finlaywashere/OpenDMXController/PCB/BOM.csv

ID | Name | Designator | Footprint | Quantity | Manufacturer Part | Manufacturer | Supplier | Supplier Part | Price
1 | AVR_SPI_PROG | U7 | AVR_ICSP | 1 | 220S-2*5P H=8.5MM Ytype Gold-plated | Ckmtw | LCSC | C124423 | 0.127
2 | ATMEGA2560 | U1 | TQFP100 | 1 | ATMEGA2560-16AU | MICROCHIP | LCSC | C22460 | 10.33
3 | M08 | JP1 | 1X08_LONGPADS | 1 | Female headerHDR1X8-2.54 | BOOMELE | LCSC | C27438 | 0.075
4 | 120 | R5,R6 | R1206 | 2 | 1206W4J0121T5E | UniOhm | LCSC | C25351 | 0.003
5 | 1M | R1 | R0603 | 1 | RMC06031M1%N | Tyohm | LCSC | C269705 | 0.003
6 | 1uF | C1 | C0805 | 1 | CS2012X7R105K500NRE | Samwha Capacitor | LCSC | C516002 | 0.015
7 | 10K | R2 | R1206 | 1 | PTFR1206B10K0P9 | ResistorToday | LCSC | C351536 | 0.172
8 | SI8660AB-B-IS1 | U2 | SOIC-16_L9.9-W3.9-P1.27-LS6.0-BL | 1 | SI8660AB-B-IS1 | SILICON LABS | LCSC | C430283 | 5.444
9 | LED-0603_R | LED1,LED2,LED3,LED4 | LED-TH_BD5.8-P2.54-RD | 4 | 19-217/R6C-AL1M2VY/3T | EVERLIGHT(台湾亿光) | LCSC | C72044 | 0.014
10 | micro USBFemale | USB1 | MICRO-USB-SMD_5P-P0.65-H-F_C10418 | 1 | micro USBFemale | ValuePro | LCSC | C10418 | 0.06
11 | 1uF | C8,C9 | C0805 | 2
12 | 9pF | C2,C3 | C0805 | 2 | GJM1555C1H9R0CB01D | MuRata | LCSC | C85884 | 0.01
13 | 100nF | C4,C5,C6,C7 | C0805 | 4
14 | XLR5 | J1,J2 | XLR5-FEMALE | 2
15 | B0505S-1WR3 | U3 | PWRM-TH_B0503S-1WR2 | 1 | B0505S-1WR3 | MORNSUN | LCSC | C131038 | 1.605
16 | MCP2221A-I/ST | U4 | TSSOP-14_L5.0-W4.4-P0.65-LS6.4-BL | 1 | MCP2221A-I/ST | MICROCHIP | LCSC | C130462 | 2.311
17 | MAX485ED | U5,U6 | SOP-8_L4.9-W3.9-P1.27-LS6.0-BL | 2 | MAX485ED | HTC Korea TAEJIN Tech | LCSC | C481667 | 0.372
18 | 16MHz | X1 | OSC-SMD_4P-L3.2-W2.5-BL | 1 | 1N216000AB0D | KDS Daishinku | LCSC | C253766 | 0.319
19 | 1k | R3,R4,R7,R8,R9,R10,R11,R12 | R1206 | 8
20 | 6N137 | U8,U9 | DIP-8_L10.0-W6.5-P2.54-LS7.6-BL | 2 | 6N137 | ISOCOM | LCSC | C89369 | 0.477
