finlaywashere/OpenDMXController/PCB/Schematic.pdf

## Clock Circuit

## Biasing Resistors and Filtering

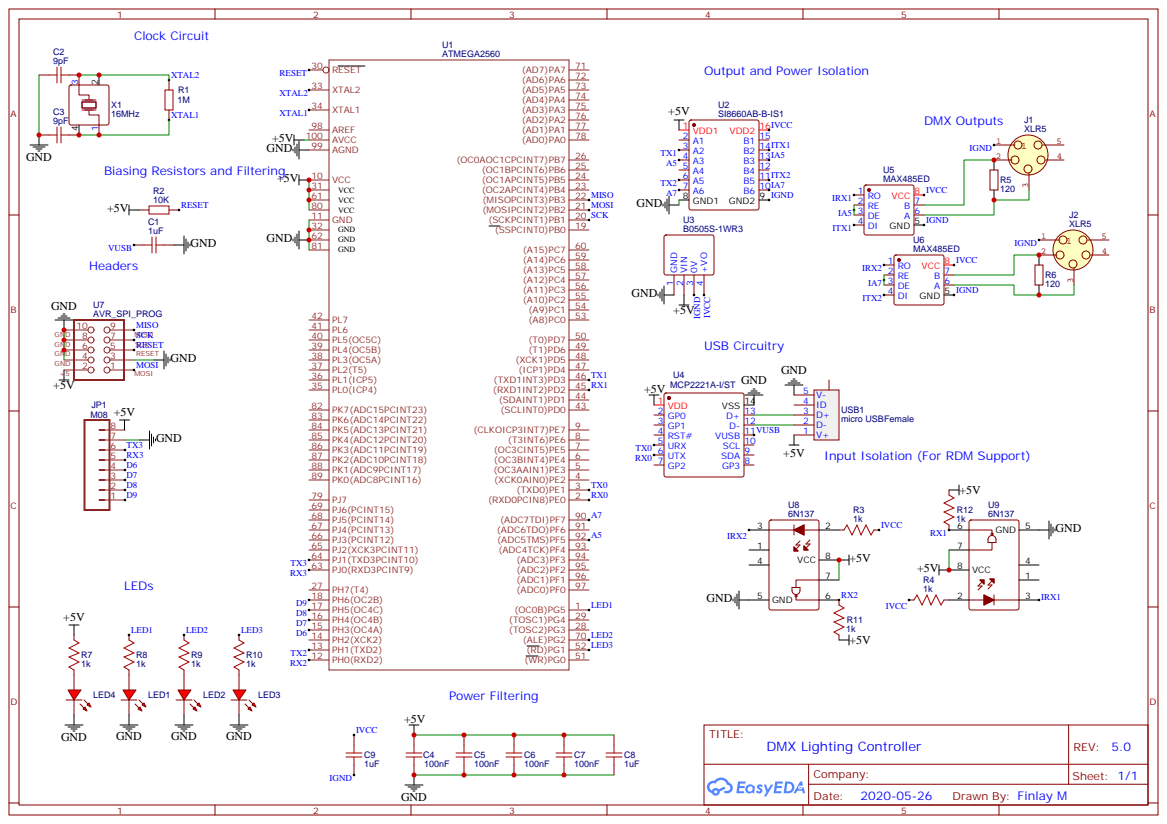
[picture p1: page 1]

Output and Power Isolation
