finlaywashere/OpenDMXController/(commit log)

2021-02-01 Added gerber file to codebase
2021-02-01 Moved gerber files to new folder and added BOM
    [BOM.xlsx]
2021-02-23 Updated gerber and added schematic
2021-03-02 Added start of readme and fixed PCB issues
2021-03-06 Updated BOM, schematic and PCB
    [BOM.xlsx]
2021-03-06 Moved arduino code file to proper name
2021-04-12 added readme with fuses info
2021-04-13 Updated code to use new baud rate and schematic
2021-04-15 I think I fixed the fuses so that hopefully everything works fine now
2021-06-03 Got firmware working and fixed weird serial issues that required hacky fixes
    [OpenDMXController.ino]
2021-06-28 Realized that the JTAGEN bit was causing all of the analog pin issues
2021-07-06 Updated PCB, schematic and BOM to be current and look neat and tidy
    [BOM.xlsx]
2021-08-31 Fixed code, added better BOM and updated schematic and gerber files for V5
    [BOM.csv, BOM.xlsx]
2021-09-04 Added device specific config file and much finer control of what is put into the compiled binary
2021-09-04 Fixed bugs and made it all work
    [OpenDMXController.ino]
